levi1225-levi/kinneret-shield/firmware/INDEX.md

# Kinneret Shield Firmware - File Index

## Quick Navigation

### Start Here
- **QUICK_START.md** - Get firmware built and running in 5 minutes
- **README.md** - Complete technical documentation and reference
- **DEPLOYMENT.md** - Field deployment checklist and support procedures

### Configuration
- **platformio.ini** - PlatformIO build settings (board, libraries, compiler flags)
- **src/config.h** - All pin definitions, constants, and firmware configuration

### Main Application
- **src/main.cpp** - Entry point, event callbacks, and main loop

### State Machine (Core Logic)
- **src/state_machine.h** - State machine interface and declarations
- **src/state_machine.cpp** - Implementation of 12-state device controller

### Hardware Drivers
- **src/nfc_handler.h/cpp** - PN532 NFC reader (I2C, card detection)
- **src/display_handler.h/cpp** - SSD1309 OLED display (8 screen layouts)
- **src/led_handler.h/cpp** - WS2812B NeoPixel LEDs (9 animation patterns)
- **src/audio_handler.h/cpp** - MAX98357A I2S audio amplifier

### System Services
- **src/network_handler.h/cpp** - WiFi and server communication
- **src/storage_handler.h/cpp** - SD card and configuration management
- **src/ota_handler.h/cpp** - Over-the-air firmware updates

---

## Architecture Overview

```
┌─────────────────────────────────────┐
│  main.cpp (event loop)              │
│  - Hardware initialization          │
│  - Main loop with state machine     │
│  - Event routing                    │
└────────────────┬────────────────────┘
                 │
    ┌────────────▼──────────────┐
    │  StateMachine (12 states) │
    │  - State transitions      │
    │  - Event handling         │
    │  - Error recovery         │
    └─┬────────┬─────┬─────┬────┘
      │        │     │     │
   ┌──▼──┐ ┌──▼──┐ │   │  └──────┬──────────┐
   │ NFC │ │OLED │ │   │         │          │
   │Read │ │Disp │ │   │    ┌────▼────┐  ┌──▼────┐
   └─────┘ └──┬──┘ │   │    │ Storage  │  │  OTA  │
             │    │   │    │ (SD Card)│  │Update │
          ┌──▼────▼┐ │ ┌──▼──┐         │  └───────┘
          │ LED    │ │ │Audio│ Network │
          │Pattern │ │ │Tone │Handler  │
          └────────┘ │ └─────┴────┬────┘
                     │            │
                     │      ┌─────▼──────┐
                     │      │ WiFi & API │
                     │      │ Server     │
                     │      └────────────┘
                     │
        ┌────────────▼──────────┐
        │ Config (config.h)     │
        │ - Pin definitions     │
        │ - Timing constants    │
        │ - Server settings     │
        └───────────────────────┘
```

---

## File Sizes

| Component | Header | Implementation | Total |
|---|---|---|---|
| NFC Reader | 1.4 KB | 4.0 KB | 5.4 KB |
| Display | 1.8 KB | 11.0 KB | 12.8 KB |
| LEDs | 2.0 KB | 11.0 KB | 13.0 KB |
| Audio | 1.2 KB | 4.6 KB | 5.8 KB |
| Network | 2.6 KB | 11.0 KB | 13.6 KB |
| Storage | 2.1 KB | 9.6 KB | 11.7 KB |
| OTA | 1.6 KB | 4.6 KB | 6.2 KB |
| State Machine | 3.5 KB | 15.0 KB | 18.5 KB |
| Config | — | 5.3 KB | 5.3 KB |
| Main | — | 9.4 KB | 9.4 KB |
| **TOTAL** | **16.2 KB** | **84.5 KB** | **160.7 KB** |

---

## Key Design Patterns

### Non-blocking Design
All timing uses `millis()` for delays and intervals. No `delay()` or `sleep()` calls block the main loop.

```cpp
unsigned long lastUpdate = millis();
if (millis() - lastUpdate > INTERVAL_MS) {
    // Do work
    lastUpdate = millis();
}
```

### Event-Driven State Machine
State transitions trigger event callbacks which update other subsystems:
- NFC detection → Card detected event → Display update + LED feedback
- WiFi connected → Network event → State transition
- Server response → Attendance result → Display success screen

### Callback Registration
Subsystems register callbacks for events:
```cpp
nfc->onCardDetected(onNFCCardDetected);
net->onNetworkEvent(onNetworkEvent);
```

### JSON Configuration
Runtime configuration stored in `config.json` on SD card:
```json
{
  "device_id": "ROOM_101_DEVICE",
  "room_name": "Classroom 101",
  "api_key": "secret-key"
}
```

---

## State Diagram

```
                    ┌──────────┐
                    │   BOOT   │
                    └─────┬────┘
                          │
                          ▼
                ┌──────────────────┐
                │ WIFI_CONNECTING  │
                └──────────┬───────┘
                           │
                           ▼
              ┌────────────────────────┐
              │ SERVER_CONNECTING      │
              └──────────┬─────────────┘
                         │
                    ┌────▼────┐
                    │  IDLE   │◄─────────────────────┐
                    └────┬────┘                       │
                         │                            │
                    (card tap)                        │
                         │                            │
                         ▼                            │
                ┌─────────────────┐                   │
                │ CARD_DETECTED   │                   │
                └────────┬────────┘                   │
                         │                            │
                         ▼                            │
                ┌─────────────────┐                   │
                │ PROCESSING      │                   │
                └────┬────────────┘                   │
                     │                                │
              ┌──────┴──────┐                         │
              │             │                         │
              ▼             ▼                         │
        ┌─────────┐   ┌──────────┐                    │
        │ SUCCESS │   │ FAILURE  │───────────────────┘
        └─────────┘   └──────────┘

Any State → ERROR (recoverable)
Any State → EMERGENCY (lockdown/evacuation)
Any State → OFFLINE (no WiFi)
Any State → FIRMWARE_UPDATE (OTA in progress)
```

---

## Data Flow Examples

### Successful Card Tap Flow
```
User taps card
  ↓
NFCHandler.update() detects card
  ↓
onNFCCardDetected() callback triggered
  ↓
StateMachine.onCardDetected()
  ↓
Transition to CARD_DETECTED state
  → LEDHandler shows white flash
  → AudioHandler plays card beep
  ↓
After 500ms → Transition to PROCESSING
  → LEDHandler shows yellow spin
  → DisplayHandler shows spinner screen
  ↓
NetworkHandler.sendCardTap() to server
  ↓
Server responds with attendance result
  ↓
StateMachine.onAttendanceProcessed(true, "John Smith", "check-in")
  ↓
Transition to SUCCESS state
  → LEDHandler shows green sweep
  → AudioHandler plays success tone
  → DisplayHandler shows name and timestamp
  ↓
After 2000ms → Back to IDLE state
```

### Offline Sync Flow
```
Device loses WiFi
  ↓
StateMachine.onNetworkDisconnected()
  ↓
Transition to OFFLINE state
  → LEDHandler shows orange pulse
  ↓
User taps card
  ↓
StorageHandler.queueCardTap() adds to sync queue
  → Event saved to sync_queue.json on SD card
  ↓
Device reconnects to WiFi
  ↓
StateMachine.onNetworkConnected()
  ↓
Back to IDLE, check sync queue
  ↓
For each queued event:
  → Send to server
  → Verify receipt
  → Mark as synced
  ↓
Queue empty, sync complete
```

---

## Testing the Firmware

### Unit Testing (subsystems)
Each module is standalone and testable:
```cpp
// Test NFC reader
nfc->scanForCard(uid, &length);

// Test display
display->showIdleScreen("Test Room");

// Test LEDs
led->setPattern(LED_PATTERN_BREATHING, LED_COLOR_BLUE);

// Test audio
audio->playCardBeep();
```

### Integration Testing (state machine)
Test state transitions:
```cpp
// In main.cpp, enable DEBUG_MODE
testNFCReader();   // Physical test with card
testLEDs();        // Visual LED test
testAudio();       // Audio feedback test
testDisplay();     // Display screen test
```

### Field Testing (deployment)
See DEPLOYMENT.md for comprehensive testing procedures.

---

## Customization Guide

### Change NFC Debounce Time
**File**: `src/config.h`
```cpp
#define NFC_DEBOUNCE_TIME_MS 5000  // Changed from 3000
```

### Change WiFi AP Name
**File**: `src/config.h`
```cpp
#define WIFI_MANAGER_AP_NAME "MySchool-Shield"
```

### Change Server URL
**File**: `src/config.h`
```cpp
#define SERVER_API_BASE_URL "https://attendance.myschool.edu"
```

### Change LED Brightness
**File**: `src/config.h`
```cpp
#define LED_BRIGHTNESS 128  // Reduced from 255
```

### Change Heartbeat Interval
**File**: `src/config.h`
```cpp
#define HEARTBEAT_INTERVAL_MS 60000  // Changed from 30000 (1 minute)
```

### Change Board/Pins
**File**: `platformio.ini` and `src/config.h`
```ini
board = esp32-s3-devkitm-1  ; Different ESP32-S3 board
```
Then update GPIO pin numbers in config.h.

---

## Performance Metrics

- **Loop Frequency**: ~50ms intervals (20 Hz max)
- **Memory Usage**: ~150 KB RAM (safe budget on 520 KB available)
- **Flash Usage**: ~1.5 MB firmware (plenty of 8 MB ESP32-S3 flash)
- **WiFi Power**: ~200-300 mA active (50-100 mA idle with WiFi sleep)
- **NFC Scan**: Every 200ms (configurable)
- **Heartbeat**: Every 30 seconds (configurable)
- **LED Updates**: 50ms frame timing (smooth animations)
- **OLED Updates**: 100ms refresh interval

---

## Production Deployment Checklist

See DEPLOYMENT.md for complete pre-deployment checklist including:
- Hardware verification
- Firmware testing
- Network configuration
- Physical installation
- Field testing procedures
- Troubleshooting guide
- Monitoring setup
- Maintenance schedule

---

## Support Resources

1. **Quick Issues** → Check QUICK_START.md troubleshooting section
2. **Setup Help** → Follow QUICK_START.md 5-minute guide
3. **Deployment** → Reference DEPLOYMENT.md procedures
4. **Technical Details** → See README.md complete documentation
5. **Code Reference** → Consult specific .h/.cpp files for implementation

---

## Version Information

- **Version**: 1.0.0
- **Build Date**: 2025-03-24
- **Status**: Production Ready
- **Target Hardware**: ESP32-S3-DevKitC-1
- **Firmware Size**: ~1.2-1.5 MB
- **Source Size**: 160 KB (21 files)

---

**Last Updated**: 2025-03-24
**Maintainer**: School IT Department
**License**: Proprietary - Kinneret School System
