levi1225-levi/kinneret-shield/Kinneret_Shield_Build_Guide.docx

KINNERET SHIELD

Complete Build Guide

Wall-Mounted NFC Attendance Device

for TanenbaumCHAT

Version 1.0 — April 2026

TIP

This guide assumes no prior experience with electronics, 3D printing, or programming. Every step is explained from scratch. If you get stuck, take a breath and re-read the step — you’ve got this.

# Table of Contents

1. What You’re Building .............. 3

2. What You Need (Shopping List) ...... 4

3. Tools Required .................... 6

4. 3D Printing the Enclosure ......... 7

5. Hardware Assembly ................. 9

6. Wiring the OLED Display ........... 12

7. Flashing the Firmware ............. 14

8. Backend Server Setup .............. 16

9. Flutter App Setup ................. 18

10. Wall Mounting .................... 19

11. Testing & First Check-In ......... 20

12. Troubleshooting .................. 21

Appendix A: Pin Reference ............ 23

Appendix B: Enclosure Dimensions ..... 24

# 1. What You’re Building

Kinneret Shield is a wall-mounted NFC check-in device designed for school attendance. Students tap their NFC card on the device as they enter the classroom. The device reads the card, sends the attendance record to a server, and shows a confirmation on screen with a sound and LED animation.

The finished device has three main layers:

- A 3D-printed enclosure (three pieces: top shell, bottom shell, and wall bracket)
- The electronics inside (HermitX ESP32-S3 board, OLED display, speaker, NFC antenna, LEDs)
- The software stack (firmware on the ESP32, a NestJS backend server, and a Flutter management app)

When everything is assembled, the device is about the size of a large smartphone — 136 mm wide, 96 mm tall, and 26 mm thick. It mounts to the wall with two screws and a bracket, and plugs in via a USB-C cable for power.

# 2. What You Need (Shopping List)

Order everything before you start. All parts are available from Amazon, Tindie, AliExpress, or your preferred electronics supplier.

## Electronics

Item | Specs | Qty | Approx. Price
HermitX ESP32-S3 NFC Card Reader Module | 99 × 62 mm PCB, PN532 NFC, MAX98357 amp, 8× WS2812B LEDs, MicroSD, USB-C | 1 | $35–45 USD
HiLetgo 2.42” SSD1309 OLED Display | 128×64 pixels, I2C (4-pin), 71 × 43.5 mm PCB | 1 | $12–18 USD
NFC Cards (NTAG213 or MIFARE Classic) | 13.56 MHz, ISO 14443A compatible | As needed | $0.50–1 each
USB-C cable | Data + power capable, at least 1 meter long | 1 | $5–10 USD
USB-C power adapter | 5V, 2A minimum (a phone charger works fine) | 1 | $8–15 USD

## Wiring Supplies

Item | Details | Qty
Female-to-female jumper wires | 20 cm length, also called DuPont wires | 4 wires
(Optional) 4-pin JST connector cable | Pre-crimped, makes a cleaner connection | 1

## 3D Printing Materials

Item | Details | Qty
PLA or PETG filament | White or natural recommended (for LED diffusion) | ~80 g
M3 × 8 mm self-tapping screws | Pan head or button head | 4
M3 × 6 mm screws + nuts | For OLED mounting posts | 4
#6 or #8 wall screws + anchors | For wall mounting (drywall anchors if needed) | 2

TIP

White or natural (translucent) filament is strongly recommended. The enclosure uses a clever built-in LED diffusion trick where the front wall is thinned to 0.6 mm at each LED position, letting light glow through the plastic. This only works well with light-colored filament.

# 3. Tools Required

## Must Have

- 3D printer (FDM, any brand — Ender 3, Prusa, Bambu, etc.)
- Computer with USB port (for firmware flashing)
- Small Phillips screwdriver (#1 size)
- Needle-nose pliers (for holding small screws)

## Nice to Have

- Digital calipers (for checking 3D print accuracy)
- Heat gun or lighter (for minor stringing cleanup on the print)
- Tweezers (for handling jumper wires in tight spaces)
- Label maker or masking tape + marker (for labeling wires)

# 4. 3D Printing the Enclosure

The enclosure has three separate parts that you print individually and then snap together. No glue is needed.

## The Three Parts

Part | Dimensions | Print Orientation | Estimated Time
Top Shell | 136 × 96 × 8 mm | Front face DOWN on the print bed | 2–3 hours
Bottom Shell | 136 × 96 × 18 mm | Open side UP | 3–4 hours
Wall Bracket | 100 × 60 × 3.5 mm | Flat (either side down) | 30–45 min

## Recommended Print Settings

Setting | Value | Why
Layer height | 0.2 mm | Good balance of speed and detail
Nozzle diameter | 0.4 mm | Standard size, works for all features
Infill | 20–25% | Strong enough without wasting filament
Infill pattern | Gyroid or Grid | Good strength in all directions
Wall count (perimeters) | 3 | Gives 1.2 mm walls — strong and clean
Top/bottom layers | 4 | Solid surface for the LED diffuser spots
Supports | YES for top shell only | The OLED window and speaker grille need support
Bed adhesion | Brim recommended | Prevents corners from lifting
Print speed | 50–60 mm/s | Slower = cleaner details
Temperature (PLA) | 200–210°C nozzle, 60°C bed | Adjust for your specific filament
Temperature (PETG) | 230–240°C nozzle, 80°C bed | PETG is tougher but trickier

WARNING

The LED diffuser spots are areas where the front wall is only 0.6 mm thick. If your slicer ignores thin walls, enable “Detect Thin Walls” or “Print Thin Walls” in your settings. In Cura this is under “Walls”; in PrusaSlicer it’s under “Layers and Perimeters.” Without this setting, the diffuser spots may not print correctly and LEDs won’t glow through.

## After Printing

1. Remove the print from the bed and let it cool completely.
2. Carefully remove support material from the OLED window and speaker grille openings on the top shell. Needle-nose pliers help here.
3. Check that the interlocking lip on the bottom shell fits into the socket on the top shell. It should be snug but not forced. If it’s too tight, gently sand the lip with fine sandpaper (220 grit).
4. Test-fit the wall bracket’s snap tabs into the rectangular slots on the bottom shell’s floor. They should click in and hold.
5. Clean up any stringing or blobs with a hobby knife or heat gun on low.

# 5. Hardware Assembly

Now you’ll put the electronics into the enclosure. Work on a clean, well-lit surface. Take your time — nothing here is fragile as long as you’re gentle.

## 5.1 Mount the PCB into the Bottom Shell

Step 1: Orient the bottom shell

Place the bottom shell open-side up on your table. You should see the four screw bosses (short cylinders) rising from the floor, plus the structural ribs between them. The USB-C cutout and MicroSD cutout are both on the same short edge — that’s the bottom wall.

Step 2: Place the HermitX board

Hold the HermitX PCB with the USB-C connector facing toward the bottom wall (the one with both port cutouts). The USB-C connector is not centered — it’s offset 13.7 mm to the right of center, so line it up with its cutout. Lower the PCB onto the four screw bosses. The four M3 mounting holes on the PCB should line up directly over the bosses.

TIP

The mounting holes are slightly asymmetric — the bottom holes are 3.5 mm from the PCB’s bottom edge, while the top holes are 5 mm from the top edge. This means the board only fits one way. If the holes don’t line up, try rotating the board 180°.

Step 3: Screw the board down

Using 4 M3 × 8 mm self-tapping screws and a small Phillips screwdriver, screw the board into the bosses. Go gently — the screws will cut their own threads into the plastic. Tighten until snug, not gorilla-tight. The PCB should sit flat on the bosses, about 5.5 mm above the floor, with no wobble.

WARNING

Do NOT over-tighten the screws. If you strip the plastic bosses, the threads won’t hold. If that happens, a drop of super glue can salvage the boss, but it’s better to just be gentle the first time.

Step 4: Stick down the NFC antenna

The NFC antenna is a separate 37.1 × 37 mm flat board with an adhesive backing. It does NOT mount on the PCB — it sticks to the inside of the top shell, behind the NFC tap zone. Set it aside for now; you’ll install it when you close up the enclosure.

## 5.2 Mount the OLED Display

Step 5: Position the OLED in the top shell

The HiLetgo 2.42” OLED has four M3 mounting holes in its corners. The top shell has four matching mounting posts on its inside face, positioned around the display window. Hold the top shell with its front face down on the table (inner side facing up). Place the OLED module face-down into the window area so the display glass sits in the window opening, resting on the 1 mm ledge around the window. The PCB mounting holes should align with the four posts.

Step 6: Secure the OLED

Use 4 M3 × 6 mm screws with nuts to attach the OLED to the mounting posts. Tighten gently. The display should be held firmly against the window ledge with no wobble.

## 5.3 Attach the Speaker

Step 7: Place the speaker

The speaker is a 32 × 24 × 6 mm rectangle with adhesive mounting. It goes on the inside of the top shell, positioned behind the speaker grille (the hexagonal hole pattern). Peel the adhesive backing off the speaker and press it firmly into place, centered behind the grille. The speaker’s connector cable should face toward the inside of the enclosure where it can reach the PCB.

# 6. Wiring the OLED Display

The OLED display communicates with the HermitX board over I2C, which needs just 4 wires. This is the only wiring you need to do — everything else (LEDs, speaker, NFC) is already connected on the HermitX board.

## What is I2C?

I2C (pronounced “I-squared-C”) is a simple communication protocol that uses two data wires plus power and ground. Multiple devices can share the same two data wires — each device has a unique address so the controller knows who it’s talking to. In this case, the PN532 NFC reader (address 0x24) and the OLED display (address 0x3C) both share the same I2C bus.

## The Four Wires

OLED Pin | Connects To | Wire Color (suggested) | What It Does
GND | GND on GPIO header | Black | Ground — the common reference point
VDD | 3V3 on GPIO header | Red | Power — 3.3 volts to run the display
SCL | IO9 on GPIO header | Yellow | Clock — timing signal for data transfer
SDA | IO10 (or IO11) | Blue | Data — carries the actual display data

WARNING

GPIO8 (the ESP32-S3 default SDA pin) is NOT broken out on the HermitX GPIO header. The visible pins are IO9, IO10, IO11, IO45, IO46, IO47, IO48. Use IO10 (or IO11) for SDA instead. The firmware is already configured to handle this — see the firmware section for the Wire.begin() call.

## How to Connect

Step 1: Identify the GPIO header on the HermitX board

Look at the left edge of the board (when the USB-C connector faces toward you). You’ll see a row of pins labeled IO9, IO10, IO11, IO45, IO46, IO47, IO48, plus power pins (3V3, GND). These are where you’ll connect your wires.

Step 2: Connect the four wires

Take four female-to-female jumper wires (the kind with plastic sockets on both ends). Connect each wire from the OLED’s 4-pin header to the matching pin on the HermitX’s GPIO header, following the table above. Push each connector firmly onto its pin until you feel it click.

TIP

Label each wire with a small piece of masking tape before connecting. It’s much easier to troubleshoot later if you know which wire is which without having to trace them.

Step 3: Route the wires cleanly

Tuck the wires along the inside walls of the enclosure. There is at least 5 mm of clearance between the PCB edges and the enclosure walls on all sides, so the wires should fit without being pinched. Avoid running wires over the NFC antenna area (center of the board) as this could interfere with card reading.

# 7. Flashing the Firmware

The firmware is the software that runs directly on the ESP32 chip inside the HermitX board. It controls the NFC reader, display, LEDs, speaker, and network communication. You need to upload ("flash") it once, and then it runs automatically whenever the device is powered on.

## What You Need on Your Computer

- Visual Studio Code (free, from code.visualstudio.com)
- PlatformIO extension for VS Code (install from the Extensions panel inside VS Code)
- A USB-C data cable (not charge-only — if your computer doesn’t see the device, try a different cable)

## Steps

Step 1: Open the firmware project

In VS Code, open the folder: kinneret-shield/firmware. PlatformIO should automatically detect the platformio.ini file and offer to set up the project. Click “Yes” if prompted to install the platform and libraries. This may take a few minutes the first time.

Step 2: Configure your settings

Open firmware/src/config.h. This file has all the settings you might want to change:

- SERVER_API_BASE_URL — change this to your backend server’s address (you’ll set this up in Section 8)
- DEVICE_ID — give this device a unique name (e.g., “ROOM_201”)
- WIFI_MANAGER_AP_NAME — the name of the Wi-Fi setup hotspot (default is “KinneretShield”)

Leave the pin definitions (I2C_SDA, I2C_SCL, NEOPIXEL_PIN, etc.) as they are unless you know you need to change them.

TIP

If you used IO10 for SDA (as recommended in Section 6), update the I2C_SDA line in config.h from 8 to 10. The line should read: #define I2C_SDA 10

Step 3: Connect the board

Plug the USB-C cable into the HermitX board and into your computer. Your computer should recognize a new serial device. On Windows, you may need to install a CP2102 or CH340 USB-serial driver (check the HermitX documentation).

Step 4: Flash the firmware

In VS Code, click the right-arrow (→) button in the PlatformIO toolbar at the bottom of the window. This compiles the code and uploads it. Watch the terminal output — it should say “Success” at the end. The board will reboot automatically.

WARNING

If the upload fails with a “connection timeout” error, you may need to put the board in bootloader mode. Hold the BOOT button on the HermitX board, press and release RESET while still holding BOOT, then release BOOT. Try uploading again. The RESET and BOOT buttons are accessible through small pinholes in the enclosure’s bottom wall (if the board is already installed).

Step 5: First boot

When the firmware starts for the first time, it creates a Wi-Fi hotspot called “KinneretShield.” Connect to it from your phone, and a setup page will appear. Enter your school’s Wi-Fi credentials. The device will save them and connect automatically on every future boot.

# 8. Backend Server Setup

The backend is a NestJS application that receives attendance data from the device, stores it in a Supabase database, and provides an API for the Flutter management app. It runs on a computer or cloud server that the device can reach over the network.

## Prerequisites

- Node.js 18 or newer (download from nodejs.org)
- npm (comes with Node.js)
- A Supabase account (free tier at supabase.com)

## Steps

Step 1: Create a Supabase project

Go to supabase.com, create a new project, and note your project URL and anon key. You’ll need these in a moment.

Step 2: Set up the database

In the Supabase dashboard, go to the SQL Editor. Open the file kinneret-shield/backend/prisma/schema.prisma to see the database schema. Run the Prisma migration to create all 22 tables:

cd kinneret-shield/backend

npm install

npx prisma migrate dev --name init

Step 3: Configure environment variables

Copy the example environment file and fill in your Supabase credentials:

cp .env.example .env

Edit the .env file with your Supabase URL, anon key, and a secret key for API authentication. The firmware’s API_KEY setting must match the key you set here.

Step 4: Start the server

npm run start:dev

The server starts on port 3000 by default. You should see “Nest application successfully started” in the terminal. The API is now running at http://localhost:3000. There are 49 API endpoints available — the device only uses two of them (/api/attendance/tap and /api/devices/heartbeat) but the Flutter app uses many more.

TIP

For production use, deploy the backend to a cloud service like Railway, Fly.io, or Render. The device needs to reach the server over the network, so “localhost” only works if the server and device are on the same machine.

# 9. Flutter App Setup

The Flutter app is a management dashboard that lets administrators, teachers, and parents view attendance data, manage devices, and configure the system. It runs on iOS, Android, and web browsers.

## Prerequisites

- Flutter SDK 3.x (install from flutter.dev)
- Android Studio or Xcode (for mobile builds) or just Chrome (for web)

## Steps

Step 1: Install dependencies

cd kinneret-shield/app

flutter pub get

Step 2: Configure the API URL

Open the app’s configuration file and set the backend URL to wherever you deployed the server in Section 8.

Step 3: Run the app

flutter run -d chrome

This launches the web version. For mobile, connect a device and run flutter run. The app has 5 role-based dashboards: Super Admin, School Admin, Teacher, Student, and Parent.

# 10. Wall Mounting

Step 1: Mark the screw positions

Hold the wall bracket against the wall where you want to mount the device. Use a pencil to mark the centers of the two keyhole slots (they’re 64 mm apart, centered on the bracket). Use a level to make sure the marks are horizontal.

Step 2: Install wall anchors

If you’re mounting into drywall, drill pilot holes and insert wall anchors. If mounting into a wooden stud, skip the anchors and go straight to screws. Use #6 or #8 screws.

Step 3: Hang the bracket

Screw in the two wall screws, leaving about 3 mm of the head sticking out. Slide the bracket’s keyhole slots over the screw heads (wide part first, then slide down so the narrow channel grips the screw shaft).

Step 4: Route the power cable

Thread your USB-C cable through the 16 × 10 mm routing hole in the center of the bracket. Plug one end into the HermitX board and the other end into a USB-C power adapter.

Step 5: Close the enclosure

Before closing up, stick the NFC antenna to the inside of the top shell, centered behind the NFC tap zone (the circular recess on the front). Make sure the antenna’s cable reaches its connector on the HermitX PCB. Then, connect any remaining cables (OLED wires, speaker cable). Place the top shell onto the bottom shell, aligning the interlocking lip. Press evenly until it clicks together.

Step 6: Snap onto the bracket

Align the bottom shell’s snap-tab recesses with the bracket’s four snap tabs, and press the enclosure onto the bracket. You should feel a light click as the tabs engage.

TIP

To remove the device from the bracket later, gently pry the snap tabs outward with a flat tool (like a guitar pick or credit card) while pulling the enclosure away from the wall.

# 11. Testing & First Check-In

Step 1: Power on

Plug in the USB-C power cable. The device should boot up within 3 seconds. You’ll see a boot screen on the OLED, hear a startup chime (C5 → G5), and all 8 LEDs will light up briefly in sequence.

Step 2: Wi-Fi connection

If you already configured Wi-Fi, the device will connect automatically. The OLED will show “Connecting...” then “Ready.” If it can’t find the network, it falls into offline mode and stores attendance locally on the MicroSD card.

Step 3: Tap a card

Hold an NFC card flat against the NFC tap zone on the front of the device. The card should be within about 3 cm. You’ll hear a beep, see the LEDs animate, and the OLED will show the result: a green checkmark for success or an error message if the card isn’t registered.

Step 4: Check the backend

Open the Flutter app or make a direct API call to your server to verify the attendance record was saved. The device sends a heartbeat every 30 seconds so you can also check that it’s showing as “online” in the management dashboard.

TIP

If the card doesn’t read, make sure you’re tapping on the NFC zone (the circular recess), not the OLED window. The NFC antenna is behind the tap zone. Also check that the antenna’s cable is plugged into the board.

# 12. Troubleshooting

## Device won’t turn on

- Check the USB-C cable. Some cables are charge-only and don’t carry data or enough power. Try a different cable.
- Make sure the power adapter is at least 5V/2A.
- Check that the USB-C connector on the board is firmly seated in the enclosure’s port cutout and not snagged.

## OLED display is blank

- Check all 4 jumper wires (GND, VDD, SCL, SDA). A loose connection is the most common cause.
- Make sure VDD goes to 3V3 (not 5V). The SSD1309 module has its own voltage regulator but the I2C logic levels must match.
- Verify config.h has I2C_SDA set to 10 (not 8) and I2C_SCL set to 9.
- Try swapping SDA and SCL wires — mixing them up is harmless and very common.

## NFC card not reading

- Make sure the NFC antenna board is stuck flat to the inside of the top shell, behind the tap zone.
- Check the antenna cable is plugged into the PN532 connector on the HermitX board.
- Move the card slowly across the tap zone — the sweet spot may be slightly off-center.
- Metal objects between the card and antenna (like a phone case or the PCB itself) can block the signal.

## LEDs not lighting up

- LEDs are controlled by GPIO 40 (NEOPIXEL_PIN in config.h). This is hardwired on the HermitX board, so there’s nothing to connect. If they’re not working, it’s likely a firmware issue — re-flash.
- Check that LED_BRIGHTNESS in config.h is set to a non-zero value (default is 255).

## Wi-Fi won’t connect

- The ESP32 only supports 2.4 GHz Wi-Fi, not 5 GHz. Make sure your network broadcasts on 2.4 GHz.
- If the device can’t find the network, it creates its own hotspot (“KinneretShield”). Connect to that and re-enter the credentials.
- School Wi-Fi with captive portals (the kind that makes you click “Accept” in a browser) won’t work. Talk to your IT department about getting a dedicated SSID or MAC-address whitelist for the device.

## Firmware upload fails

- Make sure PlatformIO detected the correct board (esp32-s3-devkitc-1).
- Try a different USB port or cable.
- Hold BOOT, press RESET, release BOOT to enter bootloader mode, then try uploading again.
- On macOS, you may need to install the Silicon Labs CP210x driver.

# Appendix A: Pin Reference

This table shows how all the pins on the HermitX ESP32-S3 NFC Card Reader Module are assigned in the Kinneret Shield firmware.

Function | GPIO Pin | Protocol | Notes
I2C SDA (NFC + OLED) | IO10 (or IO8) | I2C | Shared bus, 0x24 for PN532, 0x3C for OLED
I2C SCL (NFC + OLED) | IO9 | I2C | Clock line, shared
NeoPixel LEDs (WS2812B) | IO40 | One-wire | 8 LEDs in a row, data pin
I2S Bit Clock (Speaker) | IO41 | I2S | MAX98357A amplifier
I2S LR Clock (Speaker) | IO42 | I2S | Word select
I2S Data In (Speaker) | IO2 | I2S | Audio data
SD Card Chip Select | IO1 | SPI | MicroSD reader
SD Card MOSI | IO35 | SPI | Data out to SD
SD Card SCK | IO36 | SPI | SPI clock
SD Card MISO | IO37 | SPI | Data in from SD

# Appendix B: Enclosure Dimensions

Quick reference for the physical enclosure and the hardware inside it.

## Enclosure

Dimension | Value
Overall size (assembled) | 136 × 96 × 26 mm
Top shell depth | 8 mm
Bottom shell depth | 18 mm
Wall bracket thickness | 3.5 mm
Wall thickness | 2 mm
Corner radius | 5 mm
Interlocking lip clearance | 0.2 mm per side

## HermitX PCB

Dimension | Value
PCB size | 99 × 62 mm
PCB thickness | 1.6 mm
Mounting holes | M3, 90.7 × 53.5 mm spacing
Standoff height | 5.5 mm
USB-C offset from center | 13.7 mm right
LED count and arrangement | 8× WS2812B, horizontal line, 11.3 mm spacing
NFC antenna (separate board) | 37.1 × 37 mm, adhesive mount
Speaker | 32 × 24 × 6 mm rectangle, adhesive mount

## OLED Display

Dimension | Value
Module (HiLetgo SSD1309) | 71 × 43.5 mm PCB
Glass panel | 60.5 × 37 mm
Viewable area | 55 × 27.5 mm
Mounting holes | M3, ~66 × 38.5 mm spacing
Interface | I2C, 4-pin (GND, VDD, SCL, SDA)
I2C address | 0x3C

You did it!

Your Kinneret Shield is ready to go.

Mount it on the wall, plug it in, and start tapping.

Every tap is one less name to call during attendance.

Built for TanenbaumCHAT — Kinneret Shield v1.0

Kinneret Shield Build Guide
