levi1225-levi/kinneret-shield/firmware/src/network_handler.h

#ifndef NETWORK_HANDLER_H
#define NETWORK_HANDLER_H

#include <Arduino.h>
#include "config.h"
#include <WiFi.h>
#include <WiFiManager.h>
#include <ArduinoJson.h>
#include "storage_handler.h"

typedef void (*NetworkEventCallback)(const char* event, const char* data);

class NetworkHandler {
public:
    NetworkHandler();
    ~NetworkHandler();

    // Initialization
    void init();

    // Main update loop
    void update();

    // WiFi management
    void startWiFiManager();
    bool connectToWiFi(const char* ssid, const char* password);
    bool isWiFiConnected() const { return WiFi.status() == WL_CONNECTED; }
    int getWiFiSignal() const { return WiFi.RSSI(); }
    const char* getWiFiSSIDStr();

    // Server communication
    bool sendCardTap(const char* deviceId, uint8_t* uid, uint8_t uidLength);
    bool sendProgramWristband(const char* deviceId, uint8_t* uid, uint8_t uidLength);
    bool sendHeartbeat(const char* deviceId, const char* firmwareVersion);
    bool connectToServer();
    bool isServerConnected() const { return serverConnected; }

    // Load config from SD card
    void parseDeviceConfig(const DeviceConfig& config);

    // Event callbacks
    void onNetworkEvent(NetworkEventCallback callback) { eventCallback = callback; }

    // Status
    bool isReady() const { return initialized; }
    const char* getLastError() const { return lastError; }

private:
    // WiFi event handlers
    void handleWiFiConnected();
    void handleWiFiDisconnected();

    // HTTP helpers
    bool sendHttpPost(const char* endpoint, const char* jsonPayload);
    void parseResponseCommand(const char* jsonStr);

    // Members
    bool initialized;
    bool serverConnected;
    char lastError[64];
    char deviceId[MAX_DEVICE_ID_LENGTH];
    char apiKey[MAX_API_KEY_LENGTH];
    char roomName[MAX_ROOM_NAME_LENGTH];
    char supabaseUrl[256];
    char supabaseFunctionsUrl[256];
    char ssidBuffer[64];

    // WiFi & Server
    WiFiManager* wifiManager;
    unsigned long lastConnectionAttempt;
    unsigned long lastHeartbeatTime;
    int connectionRetries;

    // Configuration
    bool wifiSetupMode;

    // Callbacks
    NetworkEventCallback eventCallback;

    // JSON buffer
    StaticJsonDocument<JSON_BUFFER_SIZE> jsonBuffer;
};

#endif // NETWORK_HANDLER_H
