levi1225-levi/kinneret-shield/(commit log)

2026-04-02 Initial commit: Kinneret Shield complete project
    - Expo (React Native) management app with 5 role dashboards
    - NestJS + Prisma + Supabase backend with 49 API endpoints
    - ESP32-S3 PlatformIO firmware (12-state state machine)
    - 3D enclosure CAD files and Zoo Design Studio prompts
    - MicroSD card configuration files
    - Complete build guide (Word document)
    [kinneret_shield.scad]
2026-04-02 Add demo mode with mock data for all screens
    - Add mockData.ts with realistic sample data (users, rooms, devices, attendance, alerts)
    - Add demoLogin() to AuthContext that works without backend
    - Update LoginScreen to use demoLogin for demo role buttons
    - Update all 12 screens to use mock data when in demo mode
    - All 5 roles fully functional: Student, Teacher, Security, Management, Parent
    - TypeScript compiles with 0 errors
2026-04-03 Full-stack pivot to Camp Northland with Supabase backend and HermitX firmware
    - Pivot app from multi-role school system to management-only camp safety app
    - Add Supabase integration: SQL schema (11 tables), Edge Functions (device-tap, device-heartbeat), and JS client
    - Rewrite entire API layer to query Supabase directly (auth, attendance, rooms, devices, alerts, users, invites + new campers, wristbands modules)
    - Add real auth flow: Supabase email/password login with demo mode fallback
    - New login screen with email/password fields and demo mode button
    - Fix scrolling on all screens (AdminPanel FlatLists, ScrollView paddingBottom)
    - Fix tab bar truncation: rename Dashboard to Home for 6-tab l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
    [config.h, display_handler.cpp, network_handler.cpp, network_handler.h, storage_handler.cpp, storage_handler.h]
2026-04-03 Fix firmware for HermitX board and add wristband programming mode
    Rewrote firmware to match actual HermitX ESP32-S3 hardware: SPI for PN532 NFC,
    SSD1306Wire for SSD1309 OLED, correct pin mappings, stable WiFiManager portal,
    I2S audio fixes, and real Supabase URL. Added wristband programming mode for
    registering new NFC bands. Updated app screens to use real Supabase data instead
    of demo/mock data. Added program-wristband Edge Function.
    [audio_handler.cpp, config.h, display_handler.cpp, display_handler.h, main.cpp, network_handler.cpp, network_handler.h, nfc_handler.cpp]
2026-04-03 Fix processing hang, field mismatches, and add missing SQL functions
    Firmware: moved HTTP calls from onCardDetected into PROCESSING states
    with guard flag and 15s timeout so NFC taps no longer hang on
    "processing" screen forever.
    App: fixed field name mismatches across all API files and screens —
    resolved→is_resolved, room_id→location_id — to match actual DB schema.
    Supabase: added auto_checkout() and generate_daily_reports() RPC
    functions. Added device location validation in device-tap Edge Function.
    [state_machine.cpp, state_machine.h]
